PierreGicquel/CycloBoostReverse/Readme.md

Projet de vélo intelligent
==

Le projet, porté par des étudiants de seconde année à l’ESIR, a pour but de réaliser un vélo électrique intelligent contrôlable via une application Android. Pendant une période d'un mois, cette équipe composée de 7 étudiants a été affectée à ce travail afin d’avancer au mieux ce projet.

_L'équipe :_
* Houchard Corentin
* Goureau Thomas
* Duarte Sylvain
* Cotard Guillaume
* Salifou Nguetcheu
* Gael Herbrecht
* Ali Mohamed

En un mois, le projet a été réalisé puisque ce vélo est désormais contrôlable depuis une application Android via bluetooth 4.0 . L’utilisateur peut modifier le niveau d’assistance depuis son smartphone, mais il peut aussi récupérer certaines informations telles que ses records de vitesse ou encore l’historique de ses précédents trajets.

_Liste des fonctionnalités :_
1. Création sur l’application d’un compte utilisateur.
2. Authentification sur l’application d’un utilisateur.
3. Ajout d’un déplacement: lieux, départ / arrivée, vitesse moyenne et distance parcourue.
4. Affichage du parcours à l’aide d’une carte dynamique pour mieux se repérer.
5. Affichage sur l’application d’historique des anciens parcours.
6. Affichage sur l’application de la moyenne de vitesse lors des précédents parcours.
7. Appairage et connexion Bluetooth pour contrôler le vélo à l’aide de son smartphone.
8. Contrôle de la vitesse.

_Le matériel à disposition :_

Les étudiants avaient à leur disposition :
* une roue motorisée muni de son contrôleur
* une batterie cycloboost de 36V (11,6 a/h)
* un Arduino avec module bluetooth
* des composants électroniques
* des périphériques permettant d’envoyer des commandes au contrôleur.

Parmi ces périphériques il y avait un potentiomètre pour modifier la vitesse de la roue ou encore un écran LCD capable d’afficher la vitesse de la roue et la batterie restante.

_Existant :_

Ce projet ayant déjà été attribué à des étudiants de deuxième année de l’ESIR l’an passée, un certain travail avait déjà été fait.

Une précédente application Android avait été réalisé mais elle n’a pas été reprise.
Concernant le développement du programme pour l’Arduino, une petite partie avait été réalisée pour modifier la vitesse de la roue mais comme elle n’était pas fonctionnelle, elle n’a pas été réutilisée.
