PierreGicquel/CycloBoostReverse/Interfaçage.pdf

Bluetooth : Arduino ⇔ Android

Format : <numéro,valeur>

Arduino ⇒ Android
numéro | fonction | data | unité | code
1 | battery | 0-100 | % | <1,data>
2 | speed | 0-40 | km/h | <2,data>
3 | assist | 0-6 | | <3,data>
4 | error | 0-6 | | <4,data>

Android ⇒ Arduino
| fonction | data | donné
0 | stopAssist | | <0>
1 | getAssist | | <1>
2 | upAssist | | <2>
3 | downAssist | | <3>
4 | setAssist | 0-6 | <4,data>
5 | assistPieton | | <5>
6 | pot | 104 154 | <6,data>

Erreurs controller
01 | Throttle Signal Abnormality;
03 | Motor Hall Signal Abnormality;
04 | Torque Sensor Signal Abnormality;
05 | Speed Sensor Signal Abnormality (Suitable for torque system);
06 | Motor or Controller Short Circuit Abnormality;

REST
Android <==>Serveur
URL = http://lebonnuage.istic.univrennes1.fr/projet_velo_web/CodeIgniter/index.php/android (http://lebonnuage.istic.univ-rennes1.fr/projet_velo_web/CodeIgniter/index.php/user/authentification)/Methode (http://lebonnuage.istic.univ-rennes1.fr/projet_velo_web/CodeIgniter/index.php/user/authentification)
Description | Méthode | http Méthode | Paramètre
Crée un compte utilisateur | creerUser | post | login:String password :String nom :String, prenom:String, age :String mail:String
Authentifie un utilisateur | authentification | -Post | login :String mp: String
Ajout un nouveau déplacement: lieux départ/arrivée vitesse moyenne, distance parcourue | ajoutDeplacement | -Post | login:String mp :String depart:String arrivee :String vitesse :String, distance:String, mail:String
Récupérer les données d’un utilisateur en format Json. exemple : {"Id_User":"1","Login": "ali","Nom":"Mohamed Affizou","Prenom":"Ali ","Age":"23","dateInsc ription":"0000-00-00 00:00:00","adresse":"3 9 AVENUE DU PROFESSEUR CHARLES FOULON RES UNIV BEAULIEU","mail":"ali mohamedaffizou@mail .com"} | infosUser | Post | login :String mp: String
Récupérer les records de vitesse d’un utilisateur en format Json {"idHistorique":"6","id User":"1","pointDepart ":"ESIR","pointArrivee ":"INSA","vitesseMoy": "29.33","distancePar":" 2.9","date":"2016-05-01 00:00:00"},{"idHistoriq | recordVitesse | Post | login :String mp : String

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
dHis

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
dHis

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
r le

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
tilis

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
t | lo gin :S

t

rin

g
| m

p : S

t

rin

g
