PierreGicquel/CycloBoostReverse/Annexes/Reverse_engineering_frequence.png

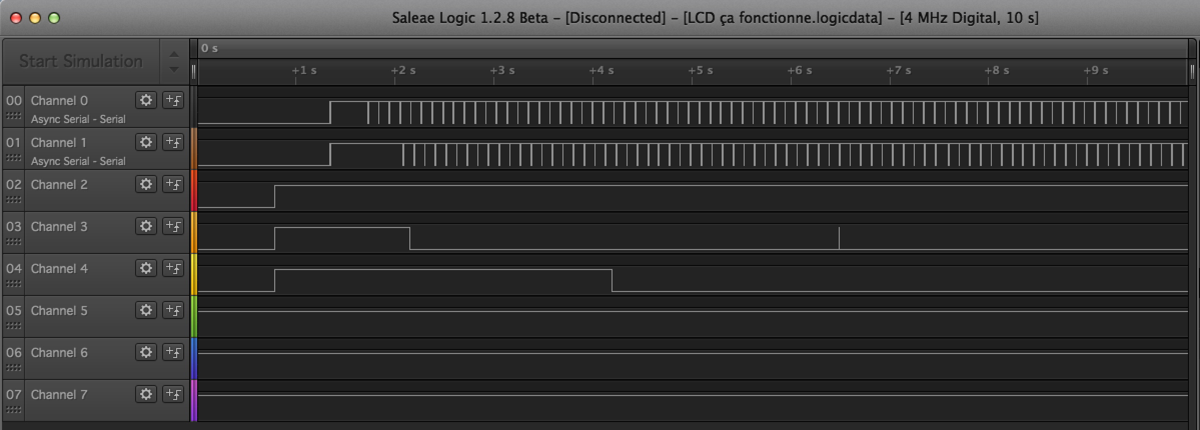
Annexes/Reverse_engineering_frequence.png
