PierreGicquel/CycloBoostReverse/Annexes/Reverse_engineering_protocole.png

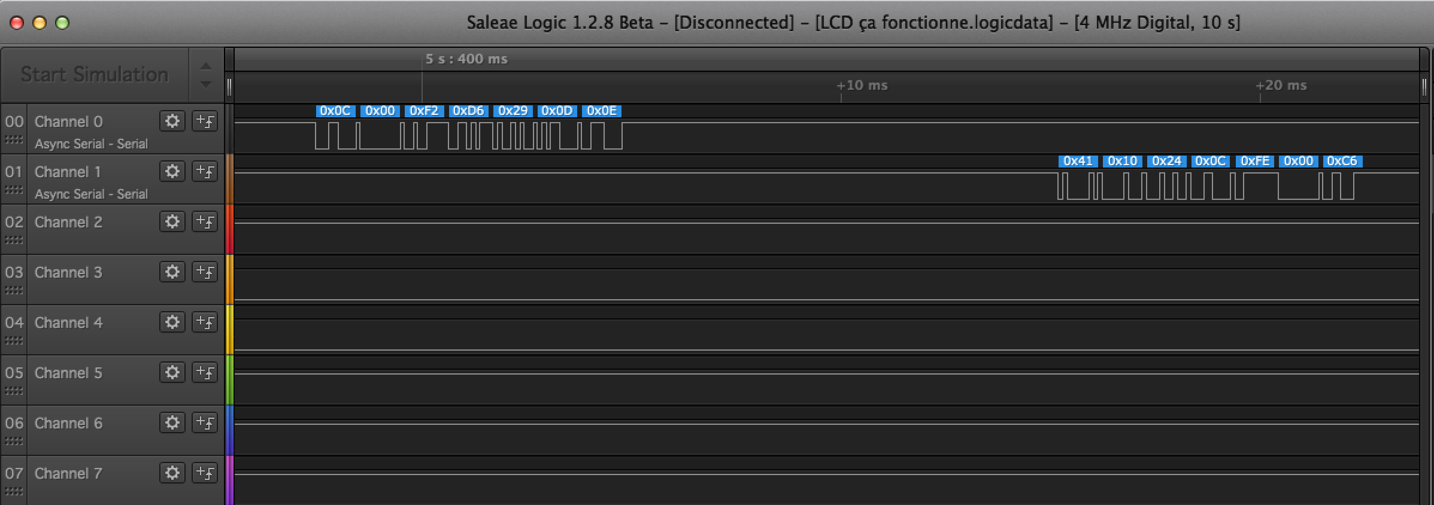
Annexes/Reverse_engineering_protocole.png
