PierreGicquel/CycloBoostReverse/Installation.md

Téléchargement des outils
===================
Arduino
----------------
Télécharger sur [le site officiel d'Arduino](url_du_lien "https://www.arduino.cc/en/Main/Software") leur IDE afin de pouvoir développer le programme à envoyer sur l'Arduino.

Android
-------------
Télécharger :
- JDK 1.7
- Android Studio ou Eclipse

BDD
-----
- [Serveur MySql](url_du_lien "https://dev.mysql.com/downloads/mysql/#downloads")
- PhpMyAdmin

Installation du projet
===================
1. Compilez puis déployez l'application Android sur un smartphone.
2. Téléversez le programme Arduino via leur IDE sur l'Arduino.
3. Mettez en place le serveur MySql sur une machine distante ou en local, puis executez le script compris dans les sources.
