PierreGicquel/CycloBoostReverse/Annexes/Montage.png

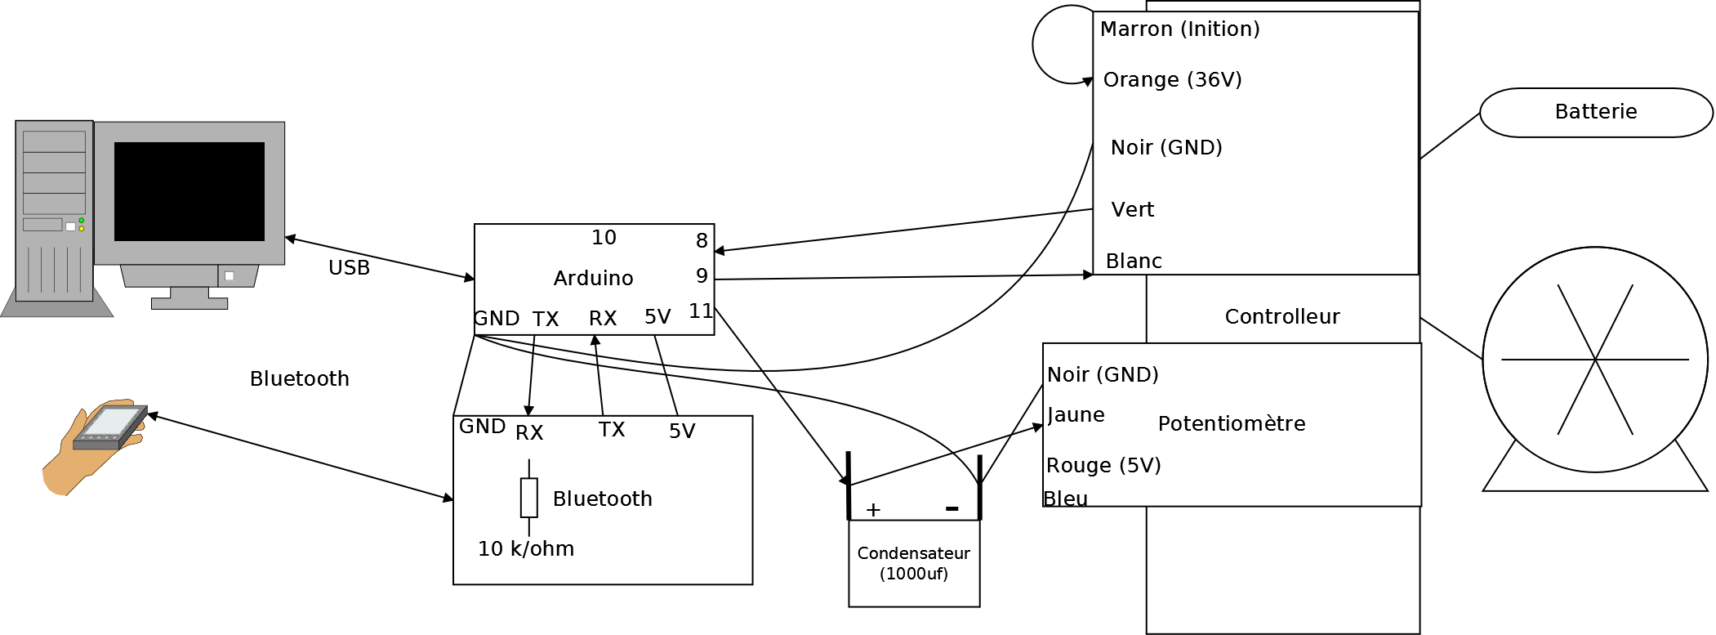
Annexes/Montage.png
